cwoodall/Open-7400-Drum-Machine/(commit log)

2011-10-10 Added and tested the clock schematic. Took pictures, need to write up and upload.
    [Clock.sch]
2011-10-10 Finished up clock/2-bit counter (and fully tested)
    [Clock.sch]
2011-10-10 Added Mux to sound circuit. Need input and output. Also added pictures. Make sure that git repo ignores Sources and Pictures so I can upload to Github
    [Clock.sch, Mux.sch]
2011-10-10 Removed all and added git ignore
    [Clock.sch, Mux.sch]
2011-10-10 Readded ignoring Pictures and Sources
    [Clock.sch, Mux.sch]
2011-10-21 Updated Schematic Files to the newest
    [Clock.sch, Debounce + Toggle.sch, Mux.sch]
